RayLiang27/MTE380-Group-7/README.md

# MTE380-Group-7
Working repository for MTE380 stewart platform project
