RayLiang27/MTE380-Group-7/CAD/V3/Beam balancer V3 BOM.xlsx

Part: Fixture
Item | Qty | Notes | Ordered/made
Acrylic | 1 | 3mm thick, WatiMake sells in stock of 12inx24in | FALSE
M5 Screws, 35mm length | 3 | (Originally 92981A911, shoulder bolts in assembly) | FALSE
M5 Screws, 25mm length | 4 | (originally 92981A050, shoulder bolts in assembly) | FALSE
M5 spacers, 19 length | 7 | (originally 94669A089), to be 3D printed, 19mm length, 10mm OD, 5.3mm ID | FALSE
M5 nuts | 7 | (originally 90591A260) | FALSE
motor mount | 1 | 3D printed | TRUE
M4 screws, 10mm length | 4 | Originally 92095A190, motor mount screws | TRUE
M4 nuts | 4 | Originally 90591A255 | TRUE
Part: Links
Item | Qty | Notes | Ordered/made
Link 1 3D print | 1 |  | TRUE
Link 2 Laser cut | 2 |  | FALSE
Link 2 3D print | 1 |  | FALSE
M3 screws, 10mm | 4 | fasteners between motor horn and link 1 | TRUE
M3 nuts | 4 |  | TRUE
M4 screws, 18mm length | 4 | Originally 92981A744, used as link pivots between link1, link 2 and platform | FALSE
M4 nuts | 4 | Originally 90591A255 | FALSE
M4 Spacers | 2 | Originally 94669A010, to be 3D printed, 6mm length, 6mm OD, 4.2mm ID | FALSE
Part: Platform
Item | Qty | Notes | Ordered/made
Platform 3D print | 1 |  | TRUE
M4 screw, 25mm length | 1 | Originally 92981A745, shoulder screw for pivot | FALSE
M4 nuts | 1 | Originally 90591A255 | FALSE
