RayLiang27/MTE380-Group-7/CAD/V5 Stepper platform/stepper mount assem.SLDASM

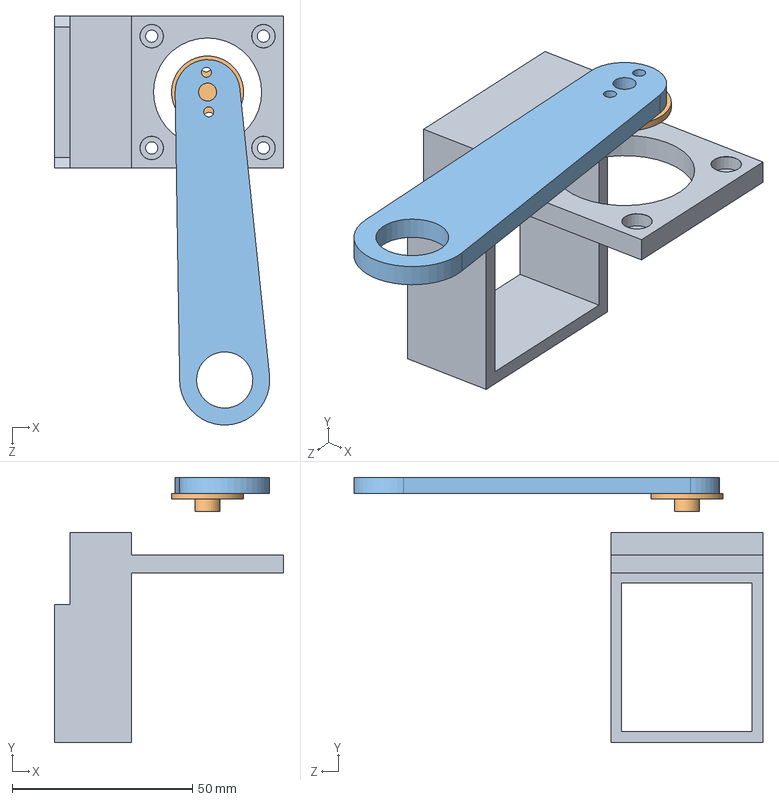
[picture p1: CAD file, 2025-11-25]
CAD/V5 Stepper platform/stepper mount assem.SLDASM
63.6 x 73.5 x 113.4 mm
Arm Link 1
stepper motor horn
stepper mount
