RayLiang27/MTE380-Group-7/CAD/V3/3D prints/beam print 2.SLDPRT

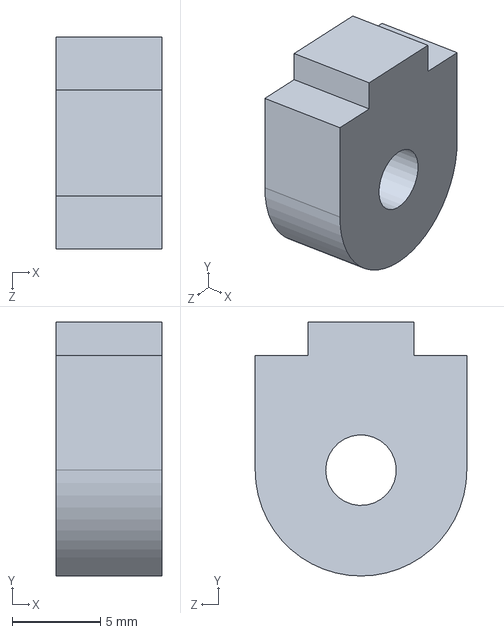
[picture p2: CAD file, 2025-09-29]
CAD/V3/3D prints/beam print 2.SLDPRT
6.00 x 14.4 x 12.0 mm
