RayLiang27/MTE380-Group-7/CAD/V3/Acrylic cutting/Acrylic cuts.SLDPRT

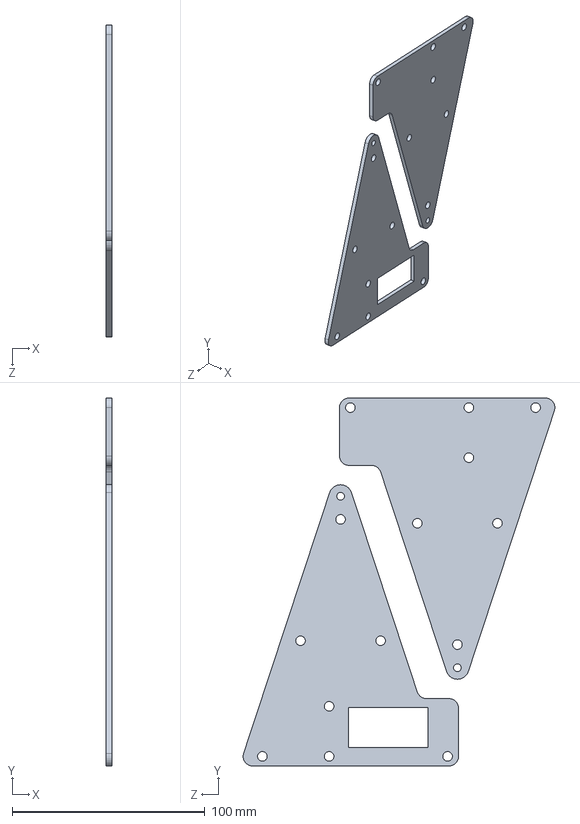
[picture p3: CAD file, 2025-09-29]
CAD/V3/Acrylic cutting/Acrylic cuts.SLDPRT
3.00 x 191.0 x 161.8 mm
