RayLiang27/MTE380-Group-7/CAD/V4 Stepper comparison/New STLs/link 1 stepper.STL

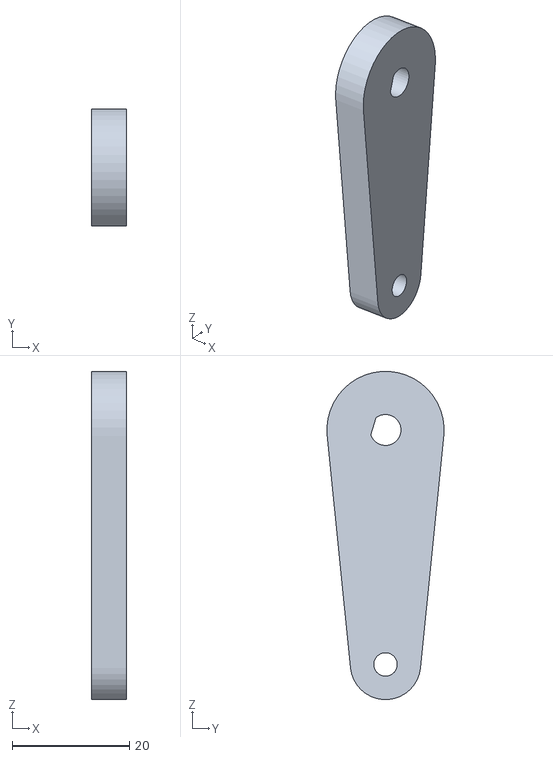
[picture p4: CAD file, 2025-11-23]
CAD/V4 Stepper comparison/New STLs/link 1 stepper.STL
6.00 x 20.0 x 56.0
