RayLiang27/MTE380-Group-7/CAD/V4 Stepper comparison/spacercap.SLDPRT

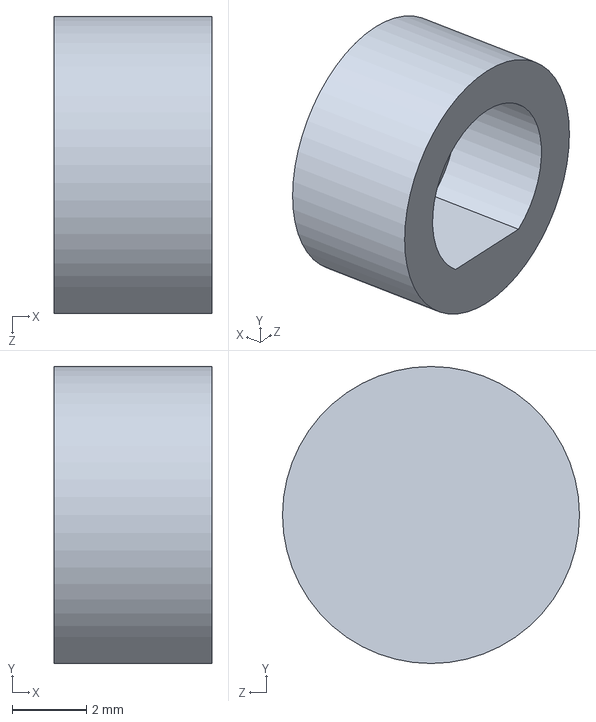
[picture p5: CAD file, 2025-11-23]
CAD/V4 Stepper comparison/spacercap.SLDPRT
4.25 x 8.00 x 8.00 mm
