RayLiang27/MTE380-Group-7/CAD/V5 Stepper platform/stepper mount.SLDPRT

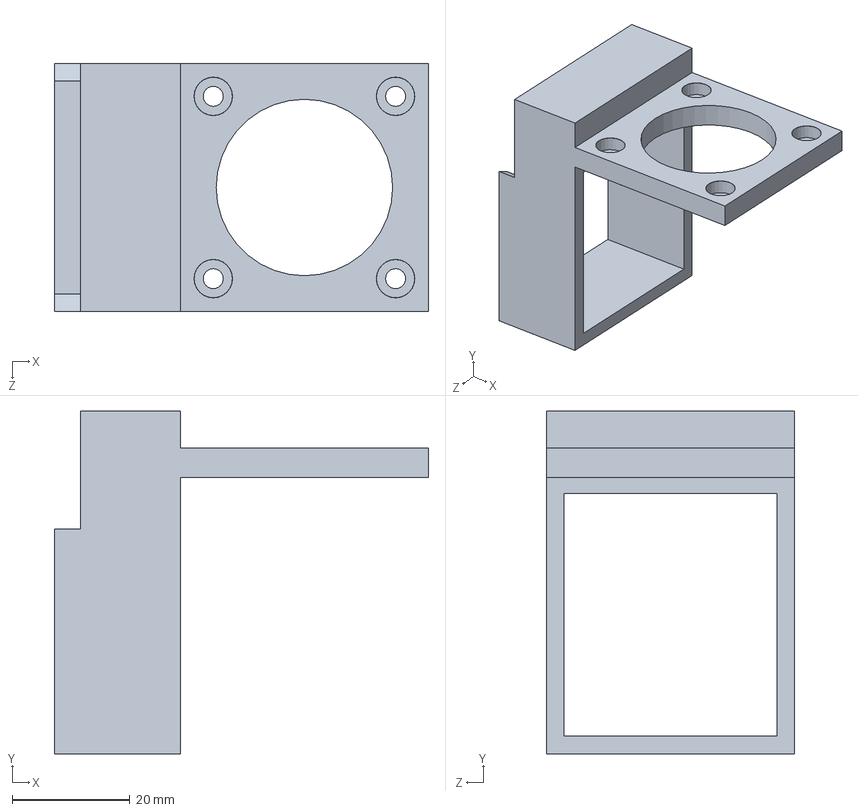
[picture p6: CAD file, 2025-11-25]
CAD/V5 Stepper platform/stepper mount.SLDPRT
63.6 x 58.2 x 42.2 mm
