RayLiang27/MTE380-Group-7/CAD/V3/3D prints/beam print 1.SLDPRT

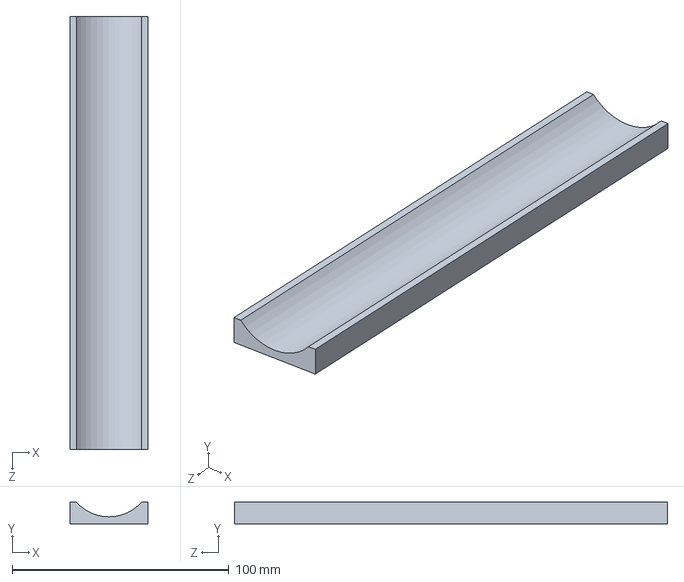
[picture p7: CAD file, 2025-09-29]
CAD/V3/3D prints/beam print 1.SLDPRT
36.0 x 10.0 x 200.0 mm
