RayLiang27/MTE380-Group-7/CAD/V3/fixture.SLDPRT

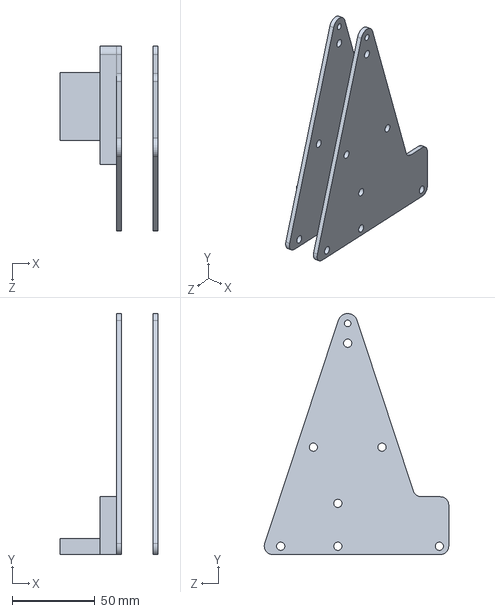
[picture p8: CAD file, 2025-11-23]
CAD/V3/fixture.SLDPRT
59.2 x 146.0 x 111.8 mm
