RayLiang27/MTE380-Group-7/CAD/V3/3D prints/motor mount (from fixture).SLDPRT

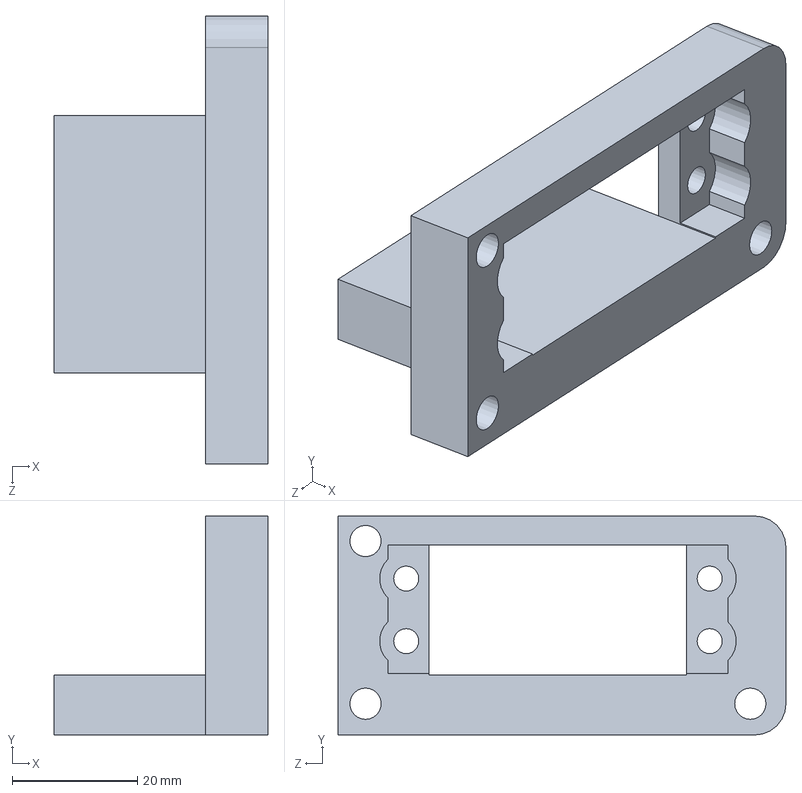
[picture p9: CAD file, 2025-09-29]
CAD/V3/3D prints/motor mount (from fixture).SLDPRT
34.2 x 35.0 x 71.6 mm
