RayLiang27/MTE380-Group-7/CAD/V4 Stepper comparison/New STLs/stepper motor mount.STL

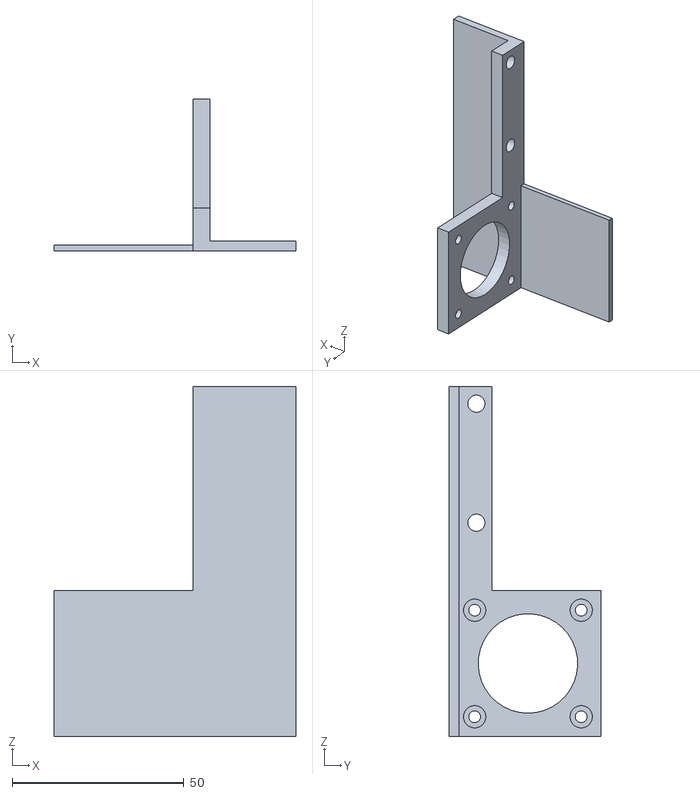
[picture p10: CAD file, 2025-11-23]
CAD/V4 Stepper comparison/New STLs/stepper motor mount.STL
70.4 x 44.3 x 101.8
