RayLiang27/MTE380-Group-7/CAD/V5 Stepper platform/stepper motor horn.SLDPRT

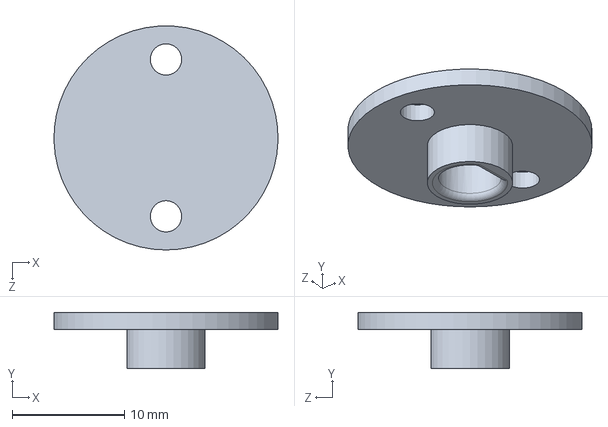
[picture p11: CAD file, 2025-11-25]
CAD/V5 Stepper platform/stepper motor horn.SLDPRT
20.0 x 5.00 x 20.0 mm
