RayLiang27/MTE380-Group-7/CAD/V3/3D prints/beam print file.SLDPRT

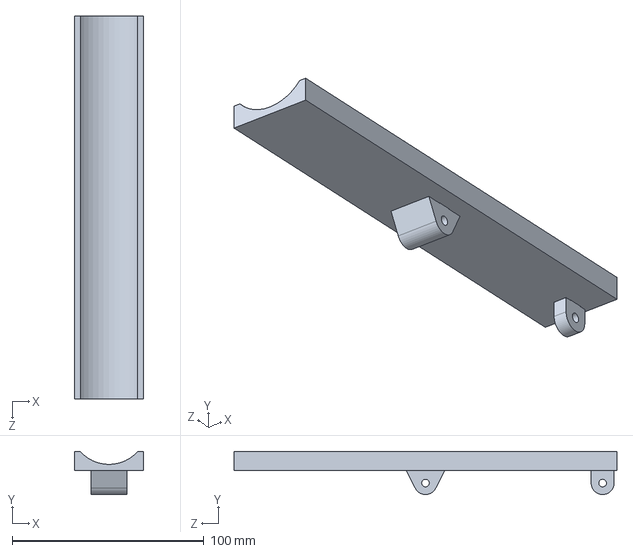
[picture p12: CAD file, 2025-09-29]
CAD/V3/3D prints/beam print file.SLDPRT
36.0 x 22.5 x 200.0 mm
