RayLiang27/MTE380-Group-7/CAD/V4 Stepper comparison/MG995R servo horn.SLDPRT

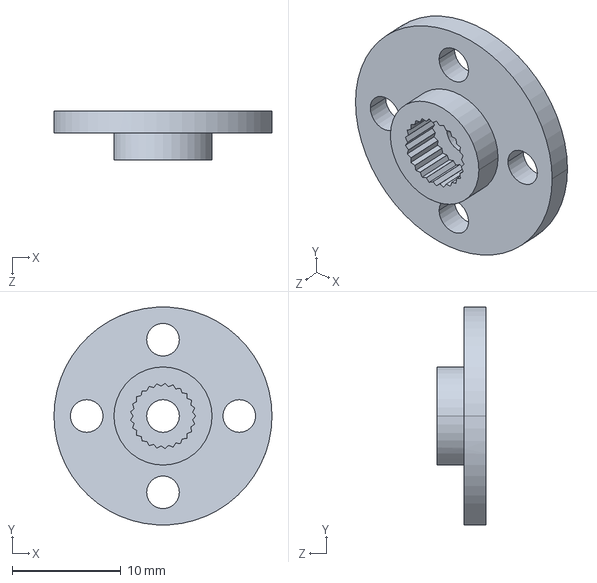
[picture p13: CAD file, 2025-11-23]
CAD/V4 Stepper comparison/MG995R servo horn.SLDPRT
20.0 x 20.0 x 4.50 mm
