RayLiang27/MTE380-Group-7/CAD/V4 Stepper comparison/New STLs/spacer1.STL

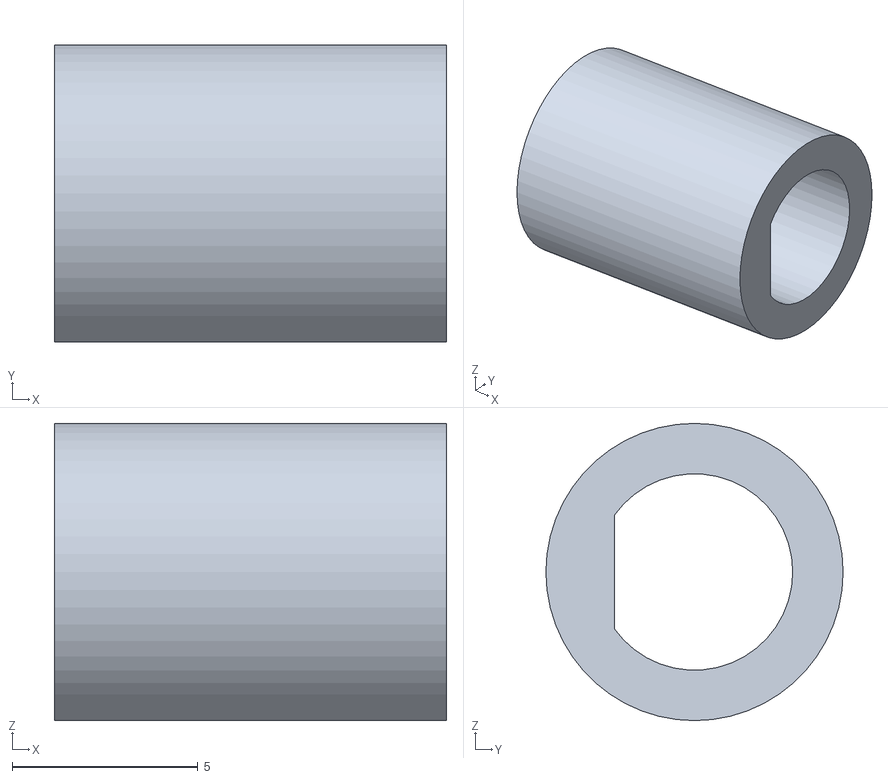
[picture p14: CAD file, 2025-11-23]
CAD/V4 Stepper comparison/New STLs/spacer1.STL
10.6 x 8.00 x 8.00
