RayLiang27/MTE380-Group-7/CAD/V5 Stepper platform/Arm Link 1.SLDPRT

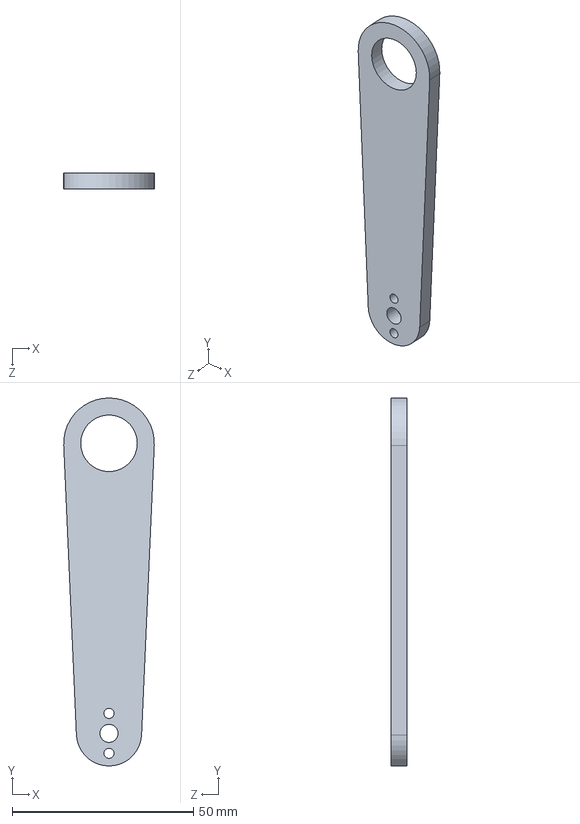
[picture p15: CAD file, 2025-11-25]
CAD/V5 Stepper platform/Arm Link 1.SLDPRT
25.0 x 101.5 x 4.50 mm
