RayLiang27/MTE380-Group-7/CAD/V3/3D prints/beam print 3.SLDPRT

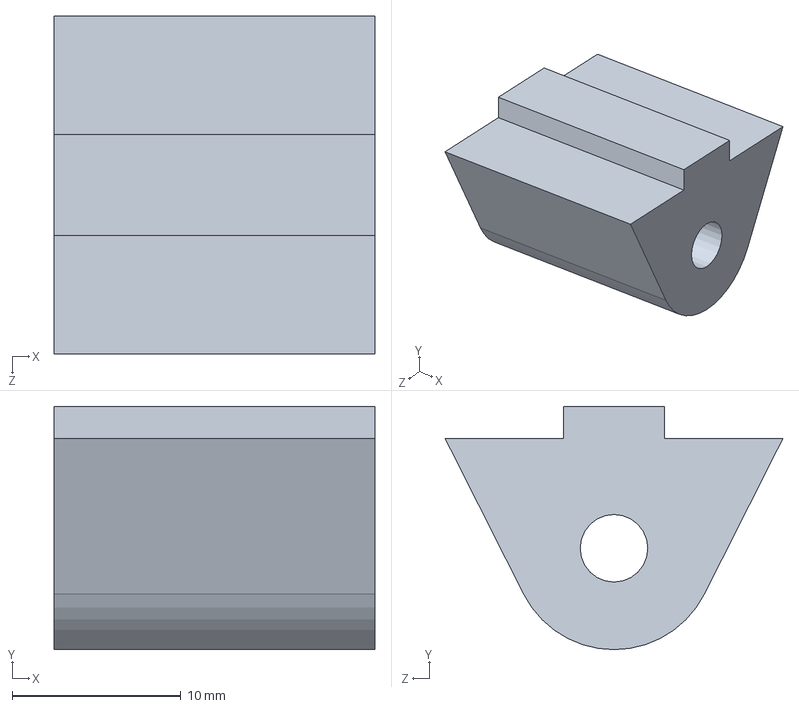
[picture p16: CAD file, 2025-09-29]
CAD/V3/3D prints/beam print 3.SLDPRT
19.0 x 14.4 x 20.0 mm
