RayLiang27/MTE380-Group-7/CAD/V5 Stepper platform/Nema 17 Shaft Coupler.SLDPRT

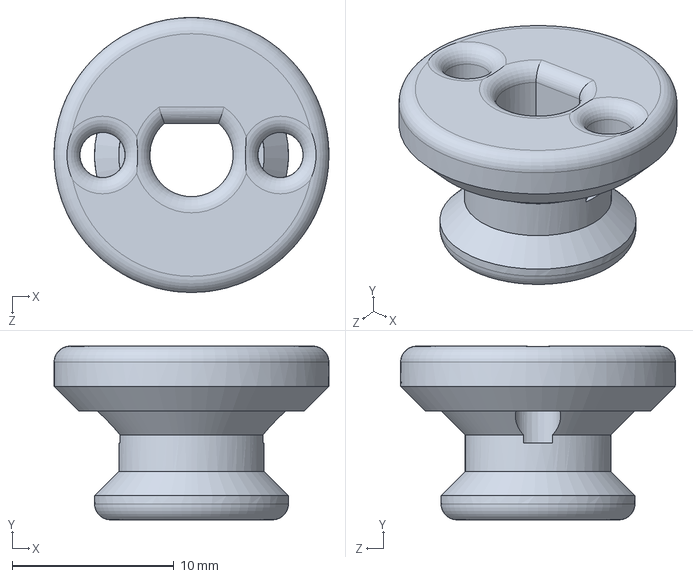
[picture p17: CAD file, 2025-11-25]
CAD/V5 Stepper platform/Nema 17 Shaft Coupler.SLDPRT
17.0 x 10.8 x 17.0 mm
