RayLiang27/MTE380-Group-7/CAD/V4 Stepper comparison/MG995R servo motor.SLDPRT

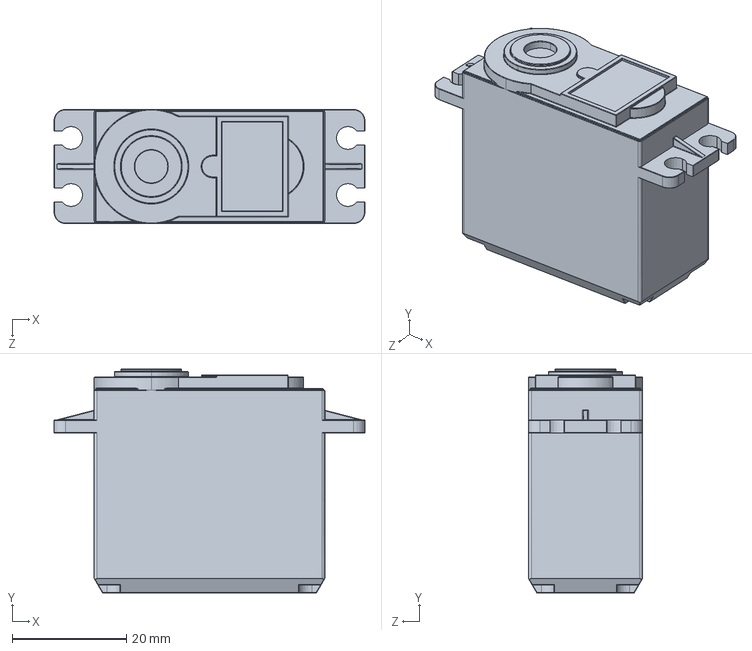
[picture p18: CAD file, 2025-11-23]
CAD/V4 Stepper comparison/MG995R servo motor.SLDPRT
54.5 x 39.2 x 20.0 mm
