RayLiang27/MTE380-Group-7/CAD/V4 Stepper comparison/ball.SLDPRT

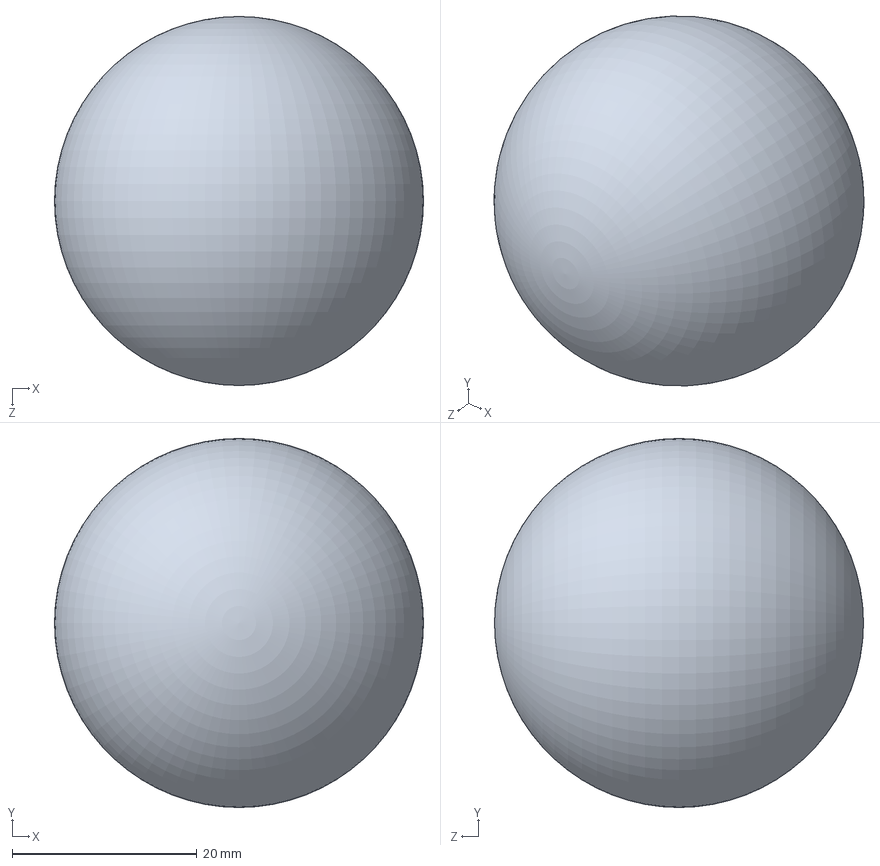
[picture p19: CAD file, 2025-09-24]
CAD/V4 Stepper comparison/ball.SLDPRT
40.0 x 40.0 x 40.0 mm
