RayLiang27/MTE380-Group-7/CAD/V3/Beam Balancer Assem V3.SLDASM

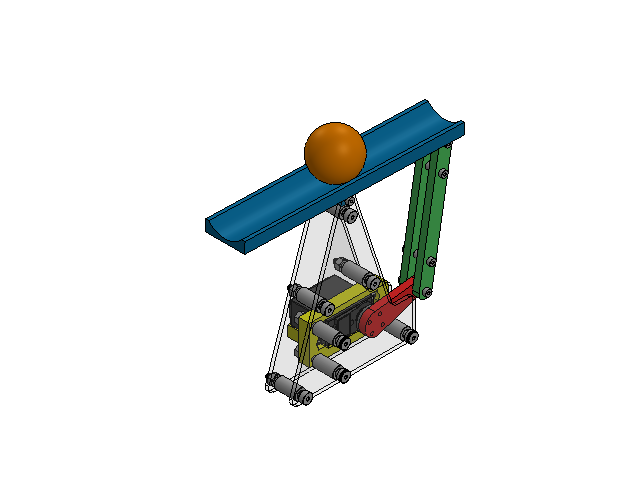
[picture p20: CAD file, 2025-11-23]
CAD/V3/Beam Balancer Assem V3.SLDASM
Beam Balancer Nodal V1
MG995R servo motor
MG995R servo horn
link 1
link 2
beam
ball
fixture
92981A745_Alloy Steel Shoulder Screws
90591A255_Zinc-Plated Steel Hex Nut x 9
92981A744_Alloy Steel Shoulder Screws x 4
94669A089_Aluminum Unthreaded Spacer x 7
92981A050_Alloy Steel Shoulder Screws x 4
92981A911_Alloy Steel Shoulder Screws x 3
90591A260_Zinc-Plated Steel Hex Nut x 7
92095A190_Button Head Hex Drive Screw x 4
94669A010_Aluminum Unthreaded Spacer x 2
