RayLiang27/MTE380-Group-7/(list of files, cad)

Other CAD files:
CAD/V3/link 1.SLDPRT
CAD/V4 Stepper comparison/beam.SLDPRT
CAD/V4 Stepper comparison/New STLs/spacercap.STL
CAD/V4 Stepper comparison/fixture.SLDPRT
CAD/V3/Beam Balancer Nodal V1.SLDPRT
CAD/V3/link 2.SLDPRT
CAD/V4 Stepper comparison/Beam Balancer Nodal V1.SLDPRT
CAD/V3/beam.SLDPRT
CAD/V4 Stepper comparison/stepper motor mount.SLDPRT
CAD/V4 Stepper comparison/spacer1.SLDPRT
CAD/V4 Stepper comparison/link 2.SLDPRT
CAD/V4 Stepper comparison/link 1.SLDPRT
CAD/V4 Stepper comparison/link 1 stepper.SLDPRT
CAD/V4 Stepper comparison/MG995R metal servo horn.STEP
CAD/V4 Stepper comparison/MG995.STEP
CAD/V1/Beam Balancer Assem V1.SLDASM
CAD/V1/Beam Balancer Nodal V1.SLDPRT
CAD/V1/MG995R servo horn.SLDPRT
CAD/V1/MG995R servo motor.SLDPRT
CAD/V1/ball.SLDPRT
CAD/V1/beam.SLDPRT
CAD/V1/fixture.SLDPRT
CAD/V1/link 1.SLDPRT
CAD/V1/link 2.SLDPRT
CAD/V2/92981A130_Alloy Steel Shoulder Screws.SLDPRT
CAD/V2/Beam Balancer Assem V2.SLDASM
CAD/V2/Beam Balancer Nodal V1.SLDPRT
CAD/V2/MG995R servo horn.SLDPRT
CAD/V2/MG995R servo motor.SLDPRT
CAD/V2/ball.SLDPRT
CAD/V2/beam.SLDPRT
CAD/V2/fixture.SLDPRT
CAD/V2/link 1.SLDPRT
CAD/V2/link 2.SLDPRT
CAD/V3/3D prints/beam print 1.STL
CAD/V3/3D prints/beam print 2.STL
CAD/V3/3D prints/beam print 3.STL
CAD/V3/3D prints/link 1.STL
CAD/V3/3D prints/motor mount (from fixture).STL
CAD/V3/Acrylic cutting/Acrylic cuts.DWG
CAD/V3/Acrylic cutting/Acrylic cuts.dxf
CAD/V4 Stepper comparison/90591A255_Zinc-Plated Steel Hex Nut.SLDPRT
CAD/V4 Stepper comparison/90591A260_Zinc-Plated Steel Hex Nut.SLDPRT
CAD/V4 Stepper comparison/92095A190_Button Head Hex Drive Screw.SLDPRT
CAD/V4 Stepper comparison/92981A050_Alloy Steel Shoulder Screws.SLDPRT
CAD/V4 Stepper comparison/92981A744_Alloy Steel Shoulder Screws.SLDPRT
CAD/V4 Stepper comparison/92981A745_Alloy Steel Shoulder Screws.SLDPRT
CAD/V4 Stepper comparison/92981A911_Alloy Steel Shoulder Screws.SLDPRT
CAD/V4 Stepper comparison/94669A010_Aluminum Unthreaded Spacer.SLDPRT
CAD/V4 Stepper comparison/94669A089_Aluminum Unthreaded Spacer.SLDPRT
