RayLiang27/MTE380-Group-7/(commit log)

2025-09-18 CAD V1 init
    - V1 nodal diagram of system
    - initialized equation file to auto update dimension of parts
    - initialized part files for link 1, link 2 and beam + link to equation files
    - imported servo files
    [Beam Balancer Assem V1.SLDASM, Beam Balancer Nodal V1.SLDPRT, MG995.STEP, MG995R metal servo horn.STEP, MG995R servo horn.SLDPRT, MG995R servo motor.SLDPRT, ball.SLDPRT, beam.SLDPRT]
2025-09-24 CAD v3
    Added folders for multiple versions of CAD
    V2:
    - small changes to balance beam
    V3:
    - first completed CAD version
    - beam pivots lowered to under the beam platform
    - distance between links in link 2 significantly reduced since it is hard to source long shoulders/spacers
    - Added MMC parts and made a motor mount
    [90591A255_Zinc-Plated Steel Hex Nut.SLDPRT, 90591A260_Zinc-Plated Steel Hex Nut.SLDPRT, 92095A190_Button Head Hex Drive Screw.SLDPRT, 92981A050_Alloy Steel Shoulder Screws.SLDPRT, 92981A130_Alloy Steel Shoulder Screws.SLDPRT, 92981A744_Alloy Steel Shoulder Screws.SLDPRT, 92981A745_Alloy Steel Shoulder Screws.SLDPRT, 92981A911_Alloy Steel Shoulder Screws.SLDPRT]
2025-09-29 V3 updated dimensions + printing CAD + BOM
    - Updated V3 with new dimensions for longer beam
    - 3D print files
    - BOM of parts in V3 assembly for ordering
    [Acrylic cuts.SLDPRT, Beam Balancer Assem V3.SLDASM, Beam Balancer Nodal V1.SLDPRT, Beam balancer V3 BOM.xlsx, beam print 1.SLDPRT, beam print 1.STL, beam print 2.SLDPRT, beam print 2.STL]
2025-09-29 Acrylic files
    - cut files for acrylic added to V3 folder
    [Acrylic cuts.DWG, Acrylic cuts.SLDPRT, Acrylic cuts.dxf]
2025-11-03 Added arduino file for sweeping motor demo
2025-11-06 v1 of stewart platform calibration script.
2025-11-06 Add beam balancer servo control file
2025-11-06 v3 calibration. added motor calibration and controller script
2025-11-07 updated angles for servo min/max
2025-11-07 Removed print statements that were clogging buffer
2025-11-09 added servo calibration sliders
2025-11-23 Stepper motor beam balancer
    1D beam balancer with stepper motor
    - 4 new 3D printed parts
    [90591A255_Zinc-Plated Steel Hex Nut.SLDPRT, 90591A260_Zinc-Plated Steel Hex Nut.SLDPRT, 92095A190_Button Head Hex Drive Screw.SLDPRT, 92981A050_Alloy Steel Shoulder Screws.SLDPRT, 92981A744_Alloy Steel Shoulder Screws.SLDPRT, 92981A745_Alloy Steel Shoulder Screws.SLDPRT, 92981A911_Alloy Steel Shoulder Screws.SLDPRT, 94669A010_Aluminum Unthreaded Spacer.SLDPRT]
2025-11-25 V5 stepper motor mount on plate balancer
    added stepper motor mounting for plate balancing
    [Arm Link 1.SLDPRT, Nema 17 Shaft Coupler.SLDPRT, stepper motor horn.SLDPRT, stepper mount assem.SLDASM, stepper mount.SLDPRT]
2025-11-25 Updated dimensions v5
    [stepper motor horn.SLDPRT, stepper mount assem.SLDASM, stepper mount.SLDPRT]
